Thierry-oshw/03_La_Boite_A_Meuh/pictures/meuh_01.jpg

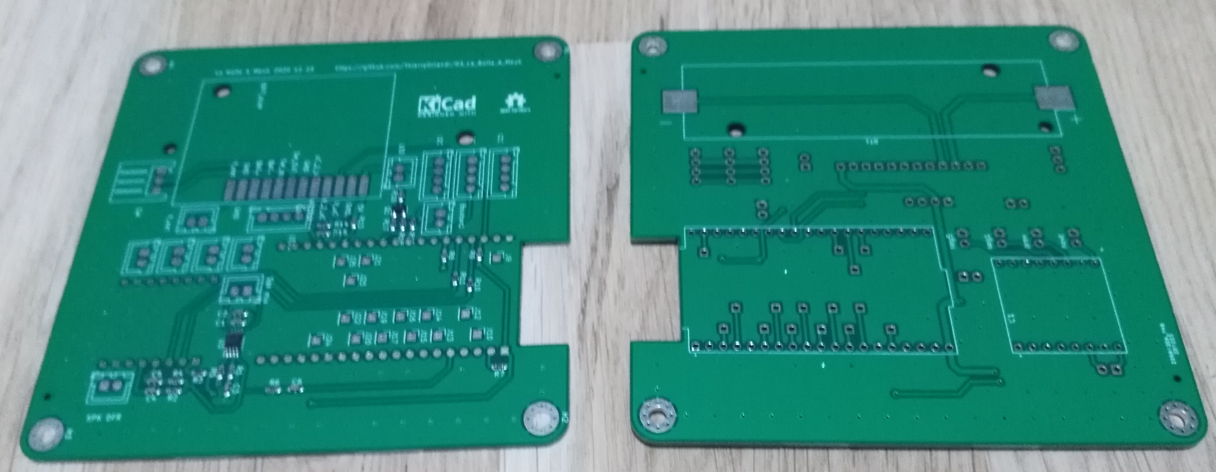
pictures/meuh_01.jpg
