Thierry-oshw/03_La_Boite_A_Meuh/donnees/cablage_mp3_player.jpg

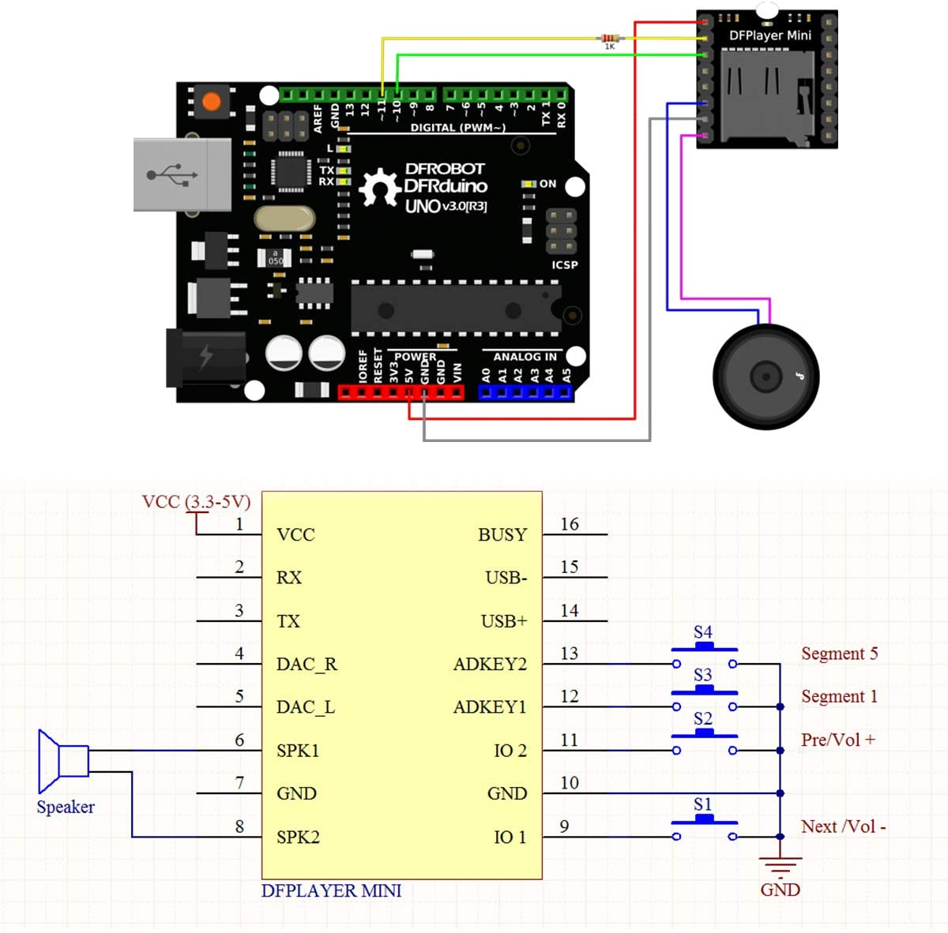
donnees/cablage_mp3_player.jpg
