Thierry-oshw/03_La_Boite_A_Meuh/donnees/pinout_mp3_player.jpg

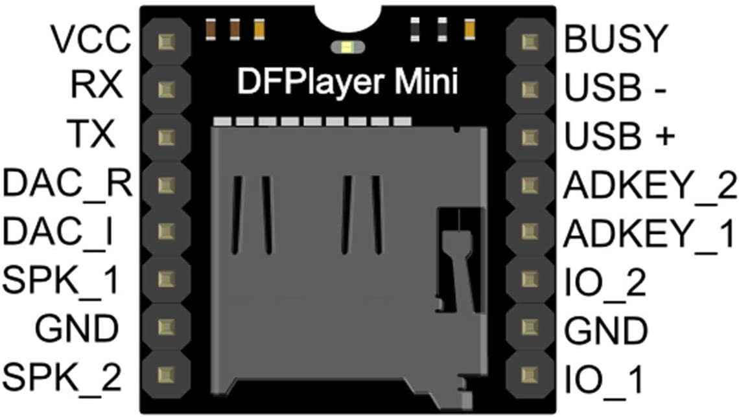
donnees/pinout_mp3_player.jpg
