Thierry-oshw/03_La_Boite_A_Meuh/03_La_Boite_A_Meuh.kicad_pcb

## KiCad design 03_La_Boite_A_Meuh.kicad_pcb (2021-09-14)

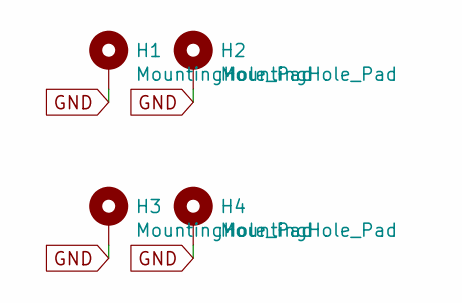
[picture p4: schematic Meca_contour.sch]

Parts:
H1, H2, H3, H4: MountingHole_Pad; MountingHole_3.2mm_M3_Pad_Via

Connections:
GND: H1.1, H2.1, H3.1, H4.1; also elsewhere on the board

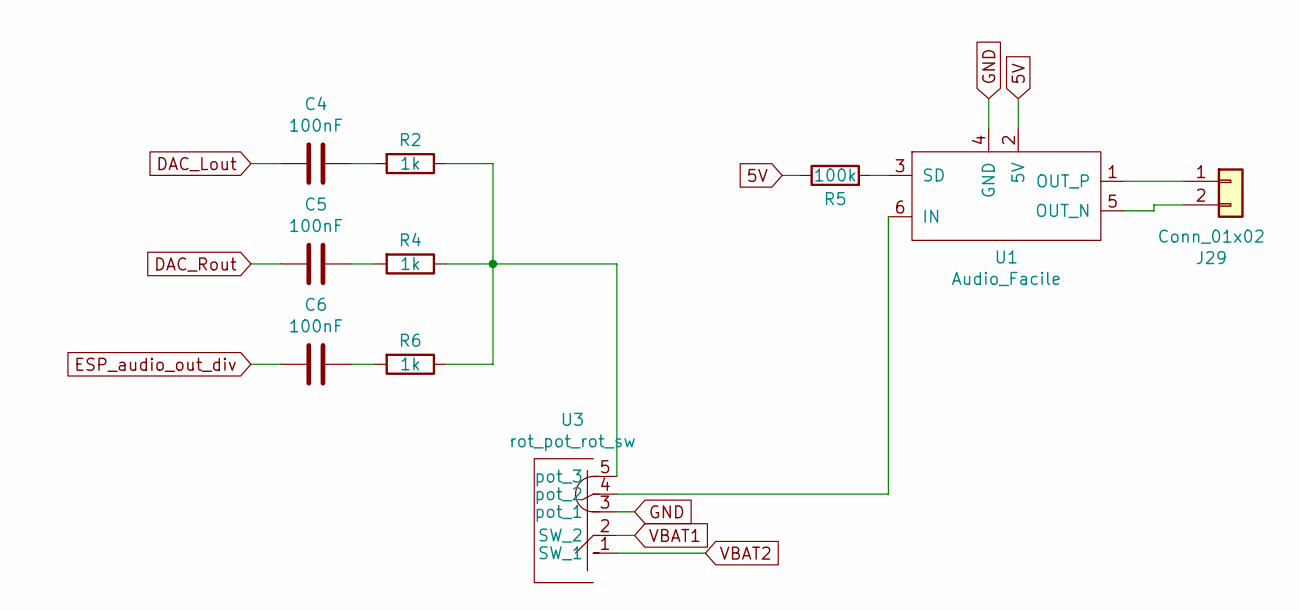
[picture p5: schematic audio.sch]

Parts:
C4, C5, C6: 100nF; C_0603_1608Metric_Pad1.05x0.95mm_HandSolder
J29: Conn_01x02; JST_XH_B2B-XH-A_1x02_P2.50mm_Vertical
R2, R4, R6: 1k; R_0603_1608Metric_Pad1.05x0.95mm_HandSolder
R5: 100k; R_0603_1608Metric_Pad1.05x0.95mm_HandSolder
U1: Audio_Facile; Audio_Facile_HP
U3: rot_pot_rot_sw; PTR901

Connections:
5V: R5.1, U1.2 (5V); also elsewhere on the board
DAC_Lout: C4.2; also elsewhere on the board
DAC_Rout: C5.2; also elsewhere on the board
ESP_audio_out_div: C6.2; also elsewhere on the board
GND: U1.4 (GND), U3.3 (pot_1); also elsewhere on the board
unnamed: C4.1, R2.2
unnamed: C5.1, R4.2
unnamed: C6.1, R6.2
unnamed: J29.1, U1.1 (OUT_P)
unnamed: J29.2, U1.5 (OUT_N)
unnamed: R2.1, R4.1, R6.1, U3.5 (pot_3)
unnamed: R5.2, U1.3 (SD)
unnamed: U1.6 (IN), U3.4 (pot_2)
VBAT1: U3.2 (SW_2); also elsewhere on the board
VBAT2: U3.1 (SW_1); also elsewhere on the board

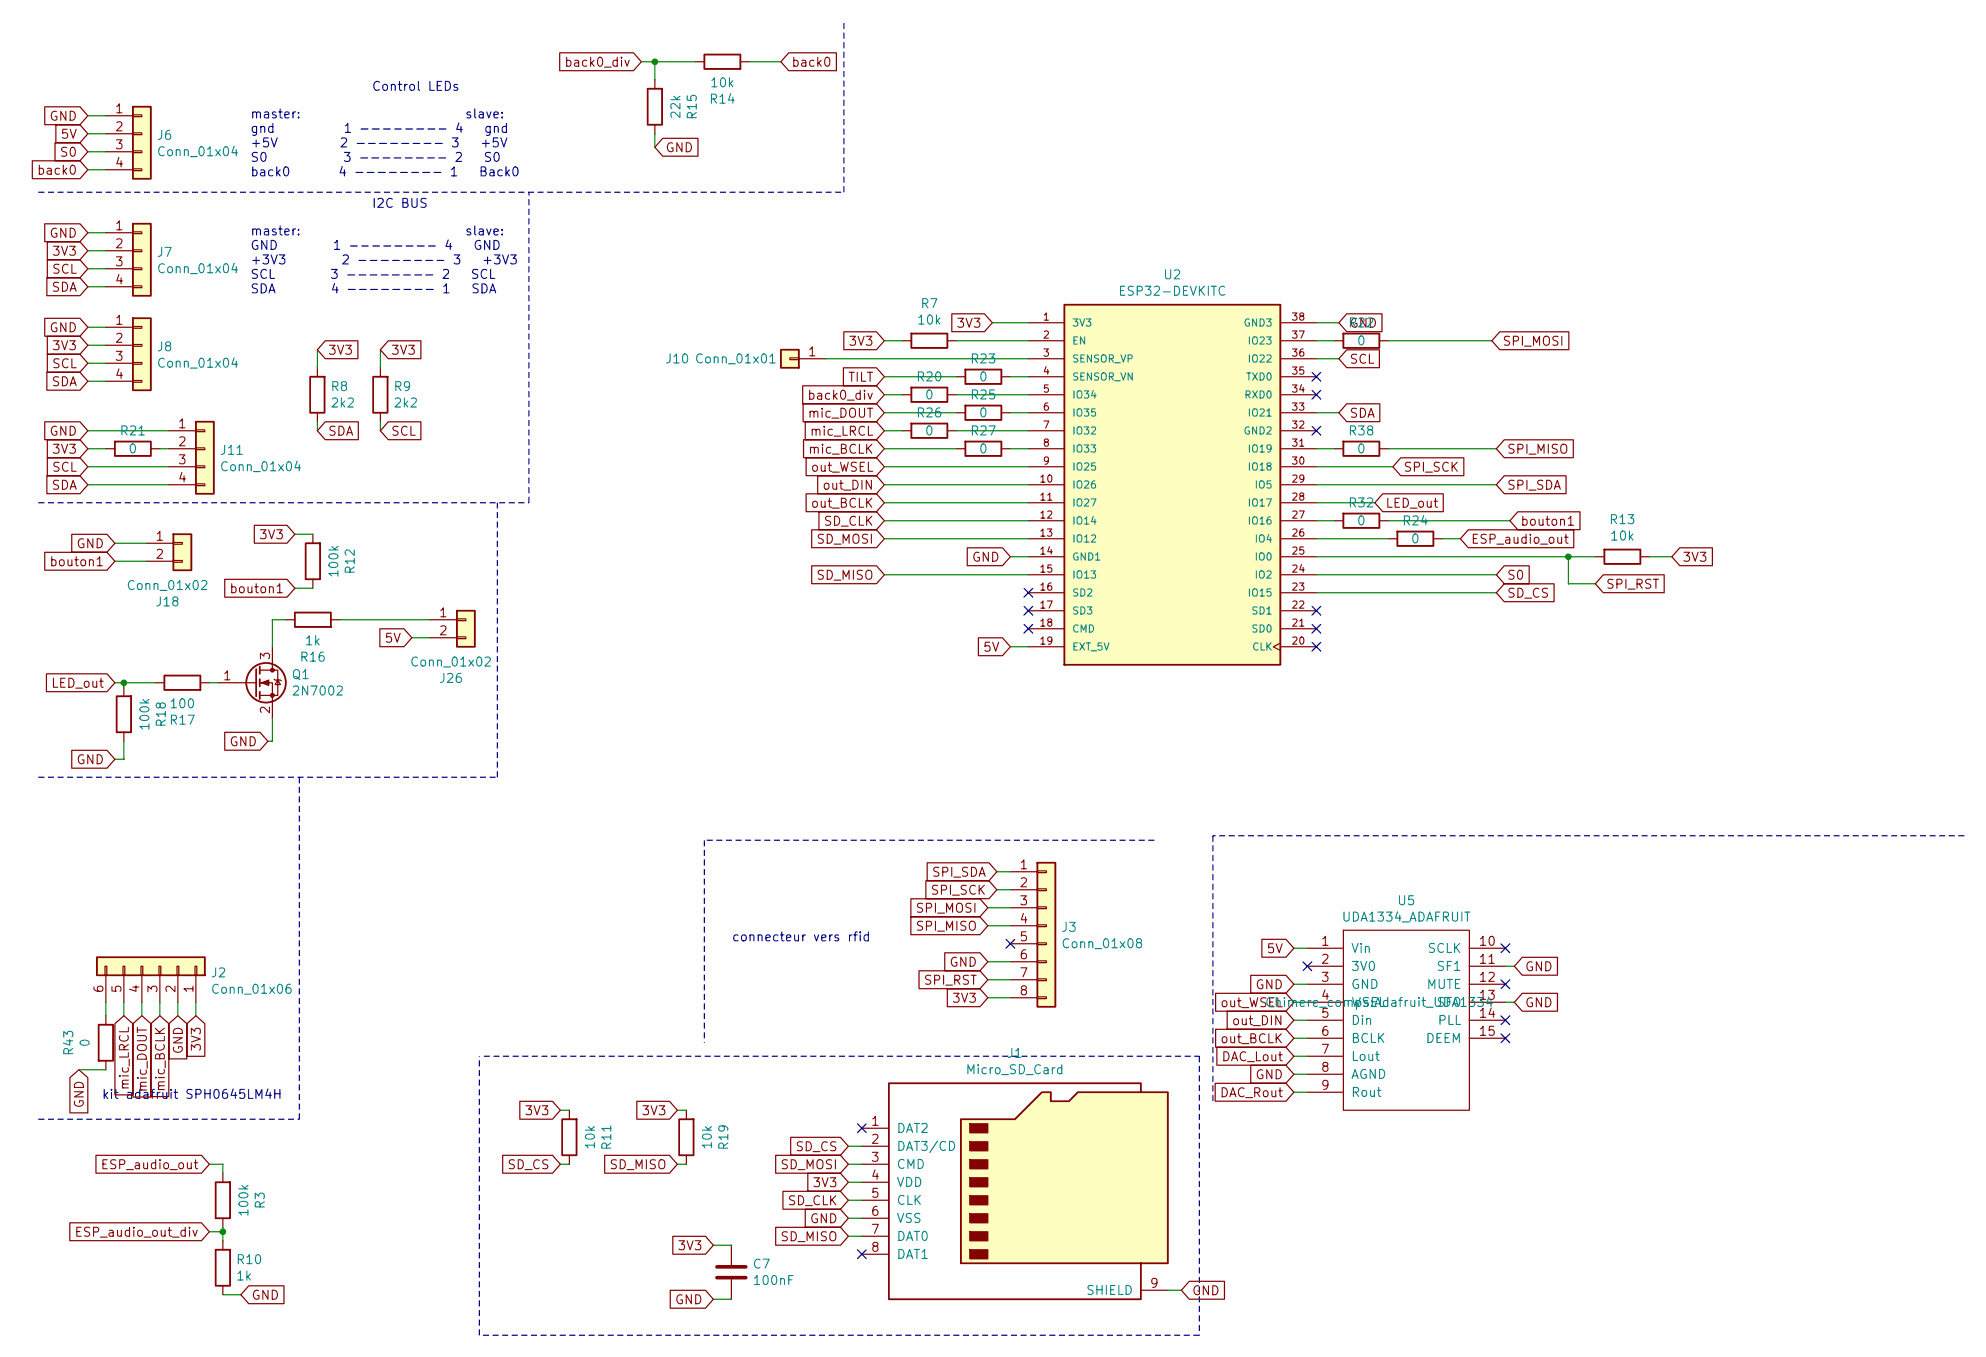
[picture p6: schematic esp32.sch]

Parts:
C7: 100nF; C_0603_1608Metric
J1: Micro_SD_Card; microSD_HC_Molex_104031-0811
J2: Conn_01x06; PinSocket_1x06_P2.54mm_Vertical
J3: Conn_01x08; PinSocket_1x08_P2.54mm_Vertical
J6: Conn_01x04; JST_XH_S4B-XH-A_1x04_P2.50mm_Horizontal
J7, J8, J11: Conn_01x04; JST_XH_B4B-XH-A_1x04_P2.50mm_Vertical
J10: Conn_01x01; PinHeader_1x01_P2.54mm_Vertical
J18, J26: Conn_01x02; JST_XH_B2B-XH-A_1x02_P2.50mm_Vertical
Q1: 2N7002; SOT-23
R3, R12, R18: 100k; R_0603_1608Metric_Pad1.05x0.95mm_HandSolder
R7, R11, R13, R14, R19: 10k; R_0603_1608Metric_Pad1.05x0.95mm_HandSolder
R8, R9: 2k2; R_0603_1608Metric_Pad1.05x0.95mm_HandSolder
R10, R16: 1k; R_0603_1608Metric_Pad1.05x0.95mm_HandSolder
R15: 22k; R_0603_1608Metric_Pad1.05x0.95mm_HandSolder
R17: 100; R_0603_1608Metric_Pad1.05x0.95mm_HandSolder
R20, R21, R22, R23, R24, R25, R26, R27, R32, R38, R43: 0; R_0603_1608Metric_Pad1.05x0.95mm_HandSolder
U2: ESP32-DEVKITC; MODULE_ESP32-DEVKITC; PARTREV N/A
U5: UDA1334_ADAFRUIT; Adafruit_UDA1334

Connections:
3V3: C7.1, J1.4 (VDD), J2.1, J3.8, J7.2, J8.2, R7.2, R8.2, R9.2, R11.2, R12.2, R13.1, R19.2, R21.2, U2.1 (3V3); also elsewhere on the board
5V: J6.2, J26.2, U2.19 (EXT_5V), U5.1 (Vin); also elsewhere on the board
DAC_Lout: U5.7 (Lout); also elsewhere on the board
DAC_Rout: U5.9 (Rout); also elsewhere on the board
ESP_audio_out: R3.2, R24.1
ESP_audio_out_div: R3.1, R10.2; also elsewhere on the board
GND: C7.2, J1.6 (VSS), J1.9 (SHIELD), J2.2, J3.6, J6.1, J7.1, J8.1, J11.1, J18.1, Q1.2 (S), R10.1, R15.1, R18.1, R43.2, U2.14 (GND1), U2.38 (GND3), U5.3 (GND), U5.8 (AGND), U5.11 (SF1), U5.13 (SF0); also elsewhere on the board
LED_out: R17.1, R18.2, U2.28 (IO17)
unnamed: J2.6, R43.1
unnamed: J10.1, U2.3 (SENSOR_VP)
unnamed: J11.2, R21.1
unnamed: J26.1, R16.2
unnamed: Q1.1 (G), R17.2
unnamed: Q1.3 (D), R16.1
unnamed: R7.1, U2.2 (EN)
unnamed: R20.1, U2.5 (IO34)
unnamed: R22.2, U2.37 (IO23)
unnamed: R23.1, U2.4 (SENSOR_VN)
unnamed: R24.2, U2.26 (IO4)
unnamed: R25.1, U2.6 (IO35)
unnamed: R26.1, U2.7 (IO32)
unnamed: R27.1, U2.8 (IO33)
unnamed: R32.2, U2.27 (IO16)
unnamed: R38.2, U2.31 (IO19)
S0: J6.3, U2.24 (IO2)
SCL: J7.3, J8.3, J11.3, R9.1, U2.36 (IO22)
SDA: J7.4, J8.4, J11.4, R8.1, U2.33 (IO21)
SD_CLK: J1.5 (CLK), U2.12 (IO14)
SD_CS: J1.2 (DAT3/CD), R11.1, U2.23 (IO15)
SD_MISO: J1.7 (DAT0), R19.1, U2.15 (IO13)
SD_MOSI: J1.3 (CMD), U2.13 (IO12)
SPI_MISO: J3.4, R38.1
SPI_MOSI: J3.3, R22.1
SPI_RST: J3.7, R13.2, U2.25 (IO0)
SPI_SCK: J3.2, U2.30 (IO18)
SPI_SDA: J3.1, U2.29 (IO5)
TILT: R23.2; also elsewhere on the board
back0: J6.4, R14.2
back0_div: R14.1, R15.2, R20.2
bouton1: J18.2, R12.1, R32.1
mic_BCLK: J2.3, R27.2
mic_DOUT: J2.4, R25.2
mic_LRCL: J2.5, R26.2
out_BCLK: U2.11 (IO27), U5.6 (BCLK)
out_DIN: U2.10 (IO26), U5.5 (Din)
out_WSEL: U2.9 (IO25), U5.4 (WSEL)

Notes on the sheet:
Control LEDs
master: slave: gnd 1 -------- 4 gnd +5V 2 -------- 3 +5V S0 3 -------- 2 S0 back0 4 -------- 1 Back0
I2C BUS
master: slave: GND 1 -------- 4 GND +3V3 2 -------- 3 +3V3 SCL 3 -------- 2 SCL SDA 4 -------- 1 SDA
kit adafruit SPH0645LM4H
connecteur vers rfid

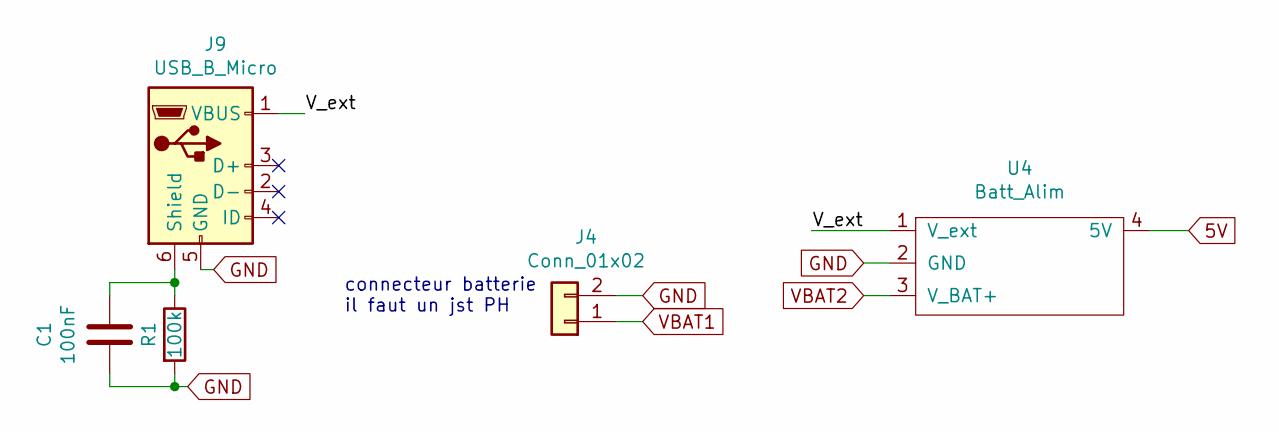
[picture p7: schematic Batt_alim.sch]

Parts:
C1: 100nF; C_0603_1608Metric_Pad1.05x0.95mm_HandSolder
J4: Conn_01x02; JST_PH_B2B-PH-K_1x02_P2.00mm_Vertical
J9: USB_B_Micro; USB_Micro-B_Wuerth_629105150521_CircularHoles
R1: 100k; R_0603_1608Metric_Pad1.05x0.95mm_HandSolder
U4: Batt_Alim; Batt_Alim_4P_HP

Connections:
5V: U4.4 (5V); also elsewhere on the board
/Batt_alim/V_ext: J9.1 (VBUS), U4.1 (V_ext)
GND: C1.2, J4.2, J9.5 (GND), R1.2, U4.2 (GND); also elsewhere on the board
unnamed: C1.1, J9.6 (Shield), R1.1
VBAT1: J4.1; also elsewhere on the board
VBAT2: U4.3 (V_BAT+); also elsewhere on the board

Notes on the sheet:
connecteur batterie il faut un jst PH

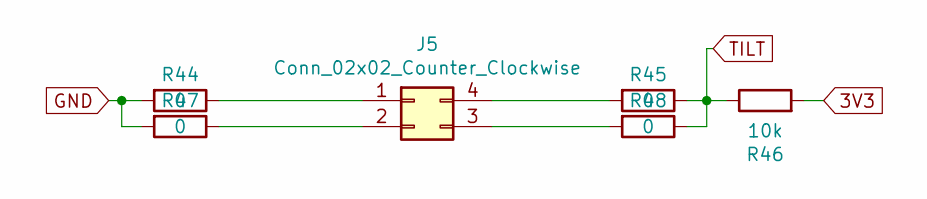
[picture p8: schematic tilt.sch]

Parts:
J5: Conn_02x02_Counter_Clockwise; PinSocket_2x02_P2.54mm_Vertical
R44, R45, R47, R48: 0; R_0603_1608Metric_Pad1.05x0.95mm_HandSolder
R46: 10k; R_0603_1608Metric_Pad1.05x0.95mm_HandSolder

Connections:
3V3: R46.2; also elsewhere on the board
GND: R44.2, R47.2; also elsewhere on the board
unnamed: J5.1, R44.1
unnamed: J5.2, R47.1
unnamed: J5.3, R48.2
unnamed: J5.4, R45.2
TILT: R45.1, R46.1, R48.1; also elsewhere on the board

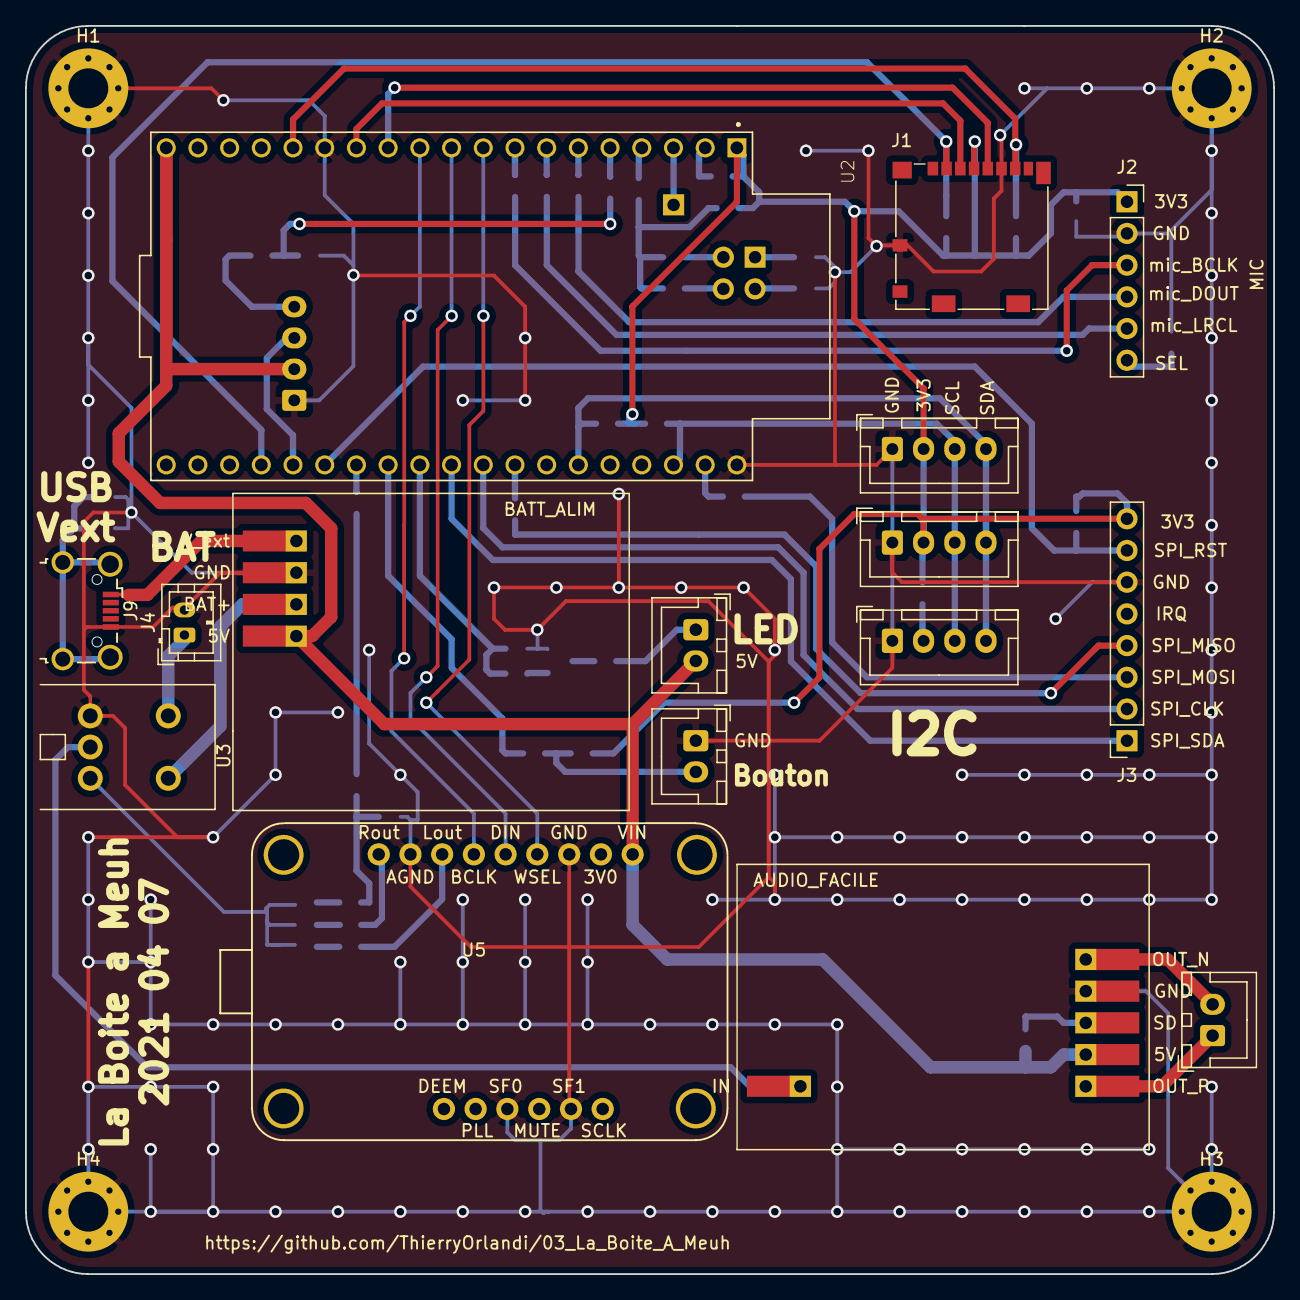
[picture p9: board 03_La_Boite_A_Meuh.kicad_pcb from above]

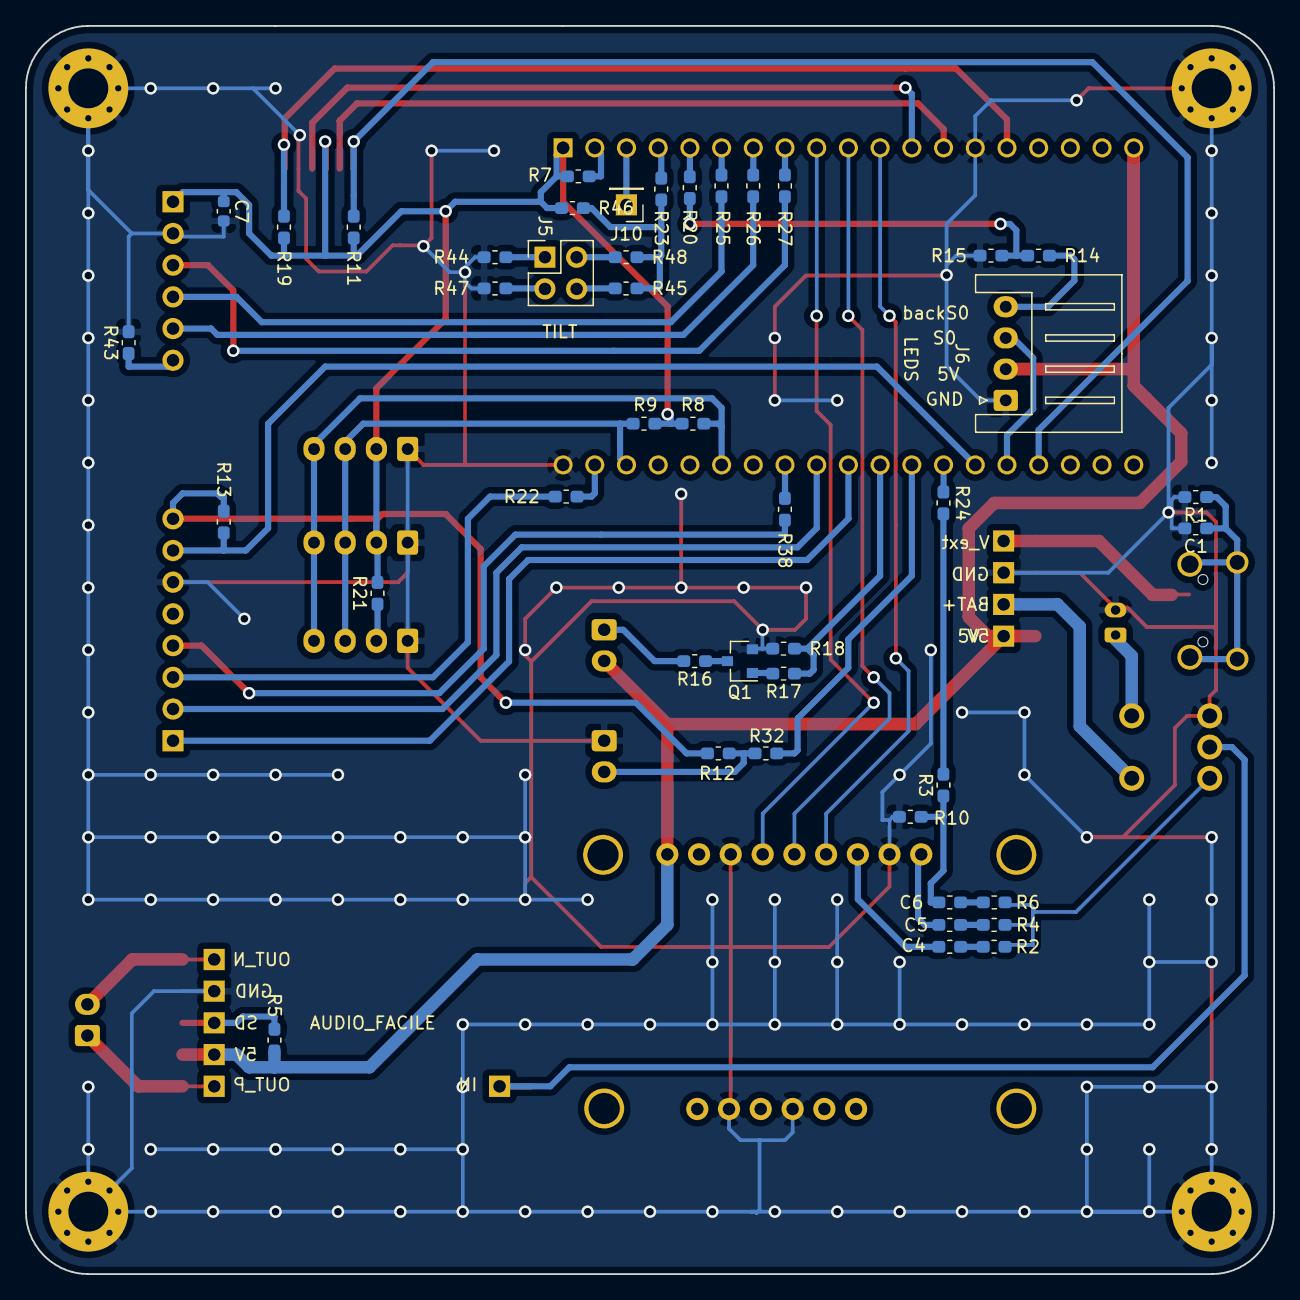
[picture p10: board 03_La_Boite_A_Meuh.kicad_pcb from below]

Board: 2 copper layers, 100.0 x 100.0 mm, 64 parts (44 on the bottom side), 62 nets.
