Thierry-oshw/03_La_Boite_A_Meuh/(commit log)

2020-12-01 add esp32 && mp3 player
    [03_La_Boite_A_Meuh.kicad_pcb, 03_La_Boite_A_Meuh.sch, Batt_alim.sch, Meca_contour.sch, audio.sch, esp32.sch]
2020-12-01 end of day save
    [Meca_contour.sch, audio.sch]
2020-12-03 ajout de la licence; added license.
2020-12-06 gitignore set to kicad version
2020-12-20 batt_alim module added
    [Batt_alim.sch, esp32.sch]
2020-12-20 added battery footprint
    and some net names
    [Batt_alim.sch, esp32.sch]
2020-12-22 fin schéma, début placement
    [03_La_Boite_A_Meuh.kicad_pcb, Batt_alim.sch, audio.sch, esp32.sch]
2020-12-23 placement ok
    [03_La_Boite_A_Meuh.kicad_pcb]
2020-12-23 routing + generation gerber
    [03_La_Boite_A_Meuh-B_Cu.gbr, 03_La_Boite_A_Meuh-B_Fab.gbr, 03_La_Boite_A_Meuh-B_Mask.gbr, 03_La_Boite_A_Meuh-B_Paste.gbr, 03_La_Boite_A_Meuh-B_SilkS.gbr, 03_La_Boite_A_Meuh-Edge_Cuts.gbr, 03_La_Boite_A_Meuh-F_Cu.gbr, 03_La_Boite_A_Meuh-F_Fab.gbr]
2021-02-13 simplifying + proper pins for uart + sd card host implemented
    [audio.sch, esp32.sch]
2021-03-07 maj
    simplification dfr
    [03_La_Boite_A_Meuh-B_Cu.gbr, 03_La_Boite_A_Meuh-B_Fab.gbr, 03_La_Boite_A_Meuh-B_Mask.gbr, 03_La_Boite_A_Meuh-B_Paste.gbr, 03_La_Boite_A_Meuh-B_SilkS.gbr, 03_La_Boite_A_Meuh-Edge_Cuts.gbr, 03_La_Boite_A_Meuh-F_Cu.gbr, 03_La_Boite_A_Meuh-F_Fab.gbr]
2021-03-24 inversion miso et mosi sdcard
    problème de pull-up au démarrage qui bloque l'esp32. Résolu en permutant les deux fils. schéma et routage corrigés
    [03_La_Boite_A_Meuh.kicad_pcb, esp32.sch]
2021-04-05 simplification
    effacé les straps des fonctions sd card et dac audio
    [esp32.sch]
2021-04-05 changement connecteur
    utilisation d'un connecteur usb micro pour l'alimentation
    [Batt_alim.sch]
2021-04-06 modification audio + alim
    utilisation du module Audio_Facile
    + utilisation d'un rotary switch rotary potentiometer
    [Batt_alim.sch, audio.sch]
2021-04-06 UDA1334
    utilisation symbole et empreinte compléte du module adafruit uda1334 à la place du simple connecteur
    [esp32.sch]
2021-04-06 ajout spi + placement + routage
    [03_La_Boite_A_Meuh.kicad_pcb, esp32.sch]
2021-04-07 correction pcb
    ajout infos sur silk
    changement connecteur jst xh 4 points pour un coudé.
    [03_La_Boite_A_Meuh-B_Cu.gbr, 03_La_Boite_A_Meuh-B_Fab.gbr, 03_La_Boite_A_Meuh-B_Mask.gbr, 03_La_Boite_A_Meuh-B_Paste.gbr, 03_La_Boite_A_Meuh-B_SilkS.gbr, 03_La_Boite_A_Meuh-Edge_Cuts.gbr, 03_La_Boite_A_Meuh-F_Cu.gbr, 03_La_Boite_A_Meuh-F_Fab.gbr]
2021-04-09 ajout strap sur dernier connecteur I2C
    [03_La_Boite_A_Meuh-B_Cu.gbr, 03_La_Boite_A_Meuh-B_Fab.gbr, 03_La_Boite_A_Meuh-B_Mask.gbr, 03_La_Boite_A_Meuh-B_Paste.gbr, 03_La_Boite_A_Meuh-B_SilkS.gbr, 03_La_Boite_A_Meuh-Edge_Cuts.gbr, 03_La_Boite_A_Meuh-F_Cu.gbr, 03_La_Boite_A_Meuh-F_Fab.gbr]
2021-04-19 maj de kicad: problème bibliothèque
2021-05-26 chgt connecteur batterie
    connecteur batterie JST XH changé pour un PH + inversion des fils. schéma + routage fait
    [03_La_Boite_A_Meuh.kicad_pcb, Batt_alim.sch]
2021-07-22 maj libraire composants
    [audio.sch]
2021-07-24 maj split librairie
    [03_La_Boite_A_Meuh.kicad_pcb, Batt_alim.sch, audio.sch, esp32.sch]
2021-09-14 passage à la version "HP" de audio facile
    [03_La_Boite_A_Meuh.kicad_pcb, audio.sch]
2021-09-14 Changement pour Batt_alim_4P version _HP
    [03_La_Boite_A_Meuh.kicad_pcb, Batt_alim.sch]
